JDWarner/organduino/(list of files, drawings)

Other design files:
PCB/development/organduino00.fzz
PCB/development/organduino2.fzz
PCB/development/organduino3.fzz
PCB/development/organduino4.fzz
PCB/development/organduino5.fzz
PCB/development/organduino6.fzz
PCB/development/organduino7.fzz
PCB/development/organduino8.fzz
PCB/development/organduino9.fzz
PCB/development/organduino10.fzz
