JDWarner/organduino/(commit log)

2016-05-04 Initial test sketch of key input w/builtin LED
2016-05-04 Fix sketch compilation errors
    [test_key.ino]
2016-05-04 FIX: Use call-by-reference for state change in subfunction
    [test_key.ino]
2016-06-04 Test version with extensible framework.
2016-06-04 Fix test MIDI sketch with proper setup and docs.
    [test_midi.ino]
2016-07-05 STY: Shortcut define no -> false for brevity.
    [midi_organ.ino]
2016-07-06 Initial prototype of OrganDuino PCB
    [organduino00.fzz]
2016-07-09 Arduino sketch now polls all manuals/pedals. No discernible lag.
2018-04-28 PCB development history
    OrganDuino variant 7 sent to production, issues recognized/corrected, OrganDuino variant 10 sent to production, deemed adequate.
    [organduino10.fzz, organduino2.fzz, organduino3.fzz, organduino4.fzz, organduino5.fzz, organduino6.fzz, organduino7.fzz, organduino8.fzz]
2018-04-29 Update README
    Remove raspberry pi, clarify.
2019-01-20 FIX: Initialize pedal monitoring pin
    [midi_organ.ino]
2019-01-20 FIX: Required ending semicolons
    [midi_organ.ino]
2019-02-04 FIX: Type definition of debounce variables.
    [midi_organ_debounce.ino]
2019-02-04 ENH: Debounce on pedals, initial framework.
    Debounce value likely will need further tweaking.
2020-04-19 DOC/ENH: Improve docs, set manuals
    The current hardware has 4 manuals and one pedalboard, so `numManuals` is set to 4. This prevents polling of 61 keys which will never be active every loop (18.1% fewer polls per loop without the 5th manual). Improved documentation.
    [midi_organ.ino]
2020-04-19 FIX: Compilation errors when numManuals reduced to 4
    [midi_organ.ino]
